radioman30/ATU_450_Tuner/docs/ATU450_Arhiva_Proiect.docx

ATU-450 TUNER CONTROLLER

Arhiva proiect — Arduino MEGA 2560

Yaesu FT-450 · BU2152FS · 24 relee · OLED · SWR Meter

# 1. Descriere proiect

Proiectul reprezinta un controller Arduino MEGA 2560 pentru tuner-ul automat de antena ATU-450, optiune pentru statia Yaesu FT-450. Controlerul inlocuieste logica originala cu un Arduino, adaugand display OLED, rotary encoder, masurare SWR in timp real, auto-tune cu hill-climbing si memorie EEPROM.

## 1.1 Hardware

Componenta | Detalii
Microcontroller | Arduino MEGA 2560
Display | OLED 1.3" SH1106 — I2C (SDA=pin20, SCL=pin21)
Driver relee | BU2152FS — 24 iesiri serial-in/parallel-out
Interfata SPI | Software: SDATA=pin11, SCLK=pin13, LE=pin10
Encoder | Rotary encoder cu buton — INT0(pin2), INT1(pin3)
Butoane | BTN_1=pin5 (mod), BTN_2=pin6 (actiune)
SWR Bridge | Punte directionala externa — FWD=A0, REV=A1
Relee | 24x NY-5W-K-IE DC5V (RL6001-RL6024)
Bobine | L6004-L6010 aer, L6011-L6013 toroidale T80

## 1.2 Versiuni cod

Versiune | Modificari
v3.0 (original) | Auto-tune +-4 pasi, fara EEPROM, 6 moduri
v4.0 (actualizat) | Hill-climbing complet, EEPROM 20 memorii, 7 moduri, fix ordine relee

# 2. IC BU2152FS — Mapare pini

BU2152FS (Rohm) este un convertor serial-in/parallel-out de 24 biti intr-un singur IC SSOP-32. Nu sunt 3 IC-uri separate — toate cele 24 relee sunt controlate de un singur chip prin interfata seriala de 4 fire.

## 2.1 Pini principali

Pin | Functie
Pin 2 | CLK — Serial Clock Input
Pin 4 | DATA — Serial Data Input
Pin 29 | SO — Serial Data Output (cascadare)
Pin 30 | STB — Strobe / Latch (activ Low)
Pin 31 | CLB — Clear (activ Low)
Pin 32 | VDD — Alimentare 5V
Pin 1, 3 | VSS — Masa
Pin 5-28 | P1...P24 — 24 iesiri paralele

## 2.2 Mapare P1-P24 catre relee (confirmata din schema)

Confirmat din schema electrica ATU-450 — pinii BU2152FS catre releele corespunzatoare:

Pin BU2152FS | Iesire Px | Releu / Functie
Pin 5 | P1 | RL6017 — Inductanta 1 (prima)
Pin 6 | P2 | RL6018 — Inductanta 2
Pin 7 | P3 | RL6019 — Inductanta 3
Pin 8 | P4 | RL6020 — Inductanta 4
Pin 9 | P5 | RL6021 — Inductanta 5
Pin 10 | P6 | RL6022 — Inductanta 6
Pin 11 | P7 | RL6023 — Inductanta 7
Pin 12 | P8 | RL6024 — Inductanta 8 (ultima)
Pin 13 | P9 | RL6009 — Condensator C2, primul
Pin 14 | P10 | RL6010 — Condensator C2
Pin 15 | P11 | RL6011 — Condensator C2
Pin 16 | P12 | RL6012 — Condensator C2
Pin 17 | P13 | RL6013 — Condensator C2
Pin 18 | P14 | RL6014 — Condensator C2
Pin 19 | P15 | RL6015 — Condensator C2
Pin 20 | P16 | RL6016 — Condensator C2, ultimul
Pin 21 | P17 | RL6001 — Condensator C1, primul
Pin 22 | P18 | RL6002 — Condensator C1
Pin 23 | P19 | RL6003 — Condensator C1
Pin 24 | P20 | RL6004 — Condensator C1
Pin 25 | P21 | RL6005 — Condensator C1
Pin 26 | P22 | RL6006 — Condensator C1
Pin 27 | P23 | RL6007 — Condensator C1
Pin 28 | P24 | RL6008 — Condensator C1, ultimul

# 3. Ordine shiftOut — Analiza si fix

## 3.1 Problema identificata

Cu shiftOut MSBFIRST, primul byte trimis este impins cel mai departe in registrul serial. Lantul intern BU2152FS:

shiftOut(byte1) -> primul trimis -> ajunge la P17-P24 = RL6001-6008 (C1)

shiftOut(byte2) -> al doilea -> ajunge la P9-P16 = RL6009-6016 (C2)

shiftOut(byte3) -> ultimul -> ajunge la P1-P8 = RL6017-6024 (L)

## 3.2 Codul v3.0 original — GRESIT

shiftOut(SDATA_PIN, SCLK_PIN, MSBFIRST, cap2); // GRESIT -> mergea la C1

shiftOut(SDATA_PIN, SCLK_PIN, MSBFIRST, cap1); // GRESIT -> mergea la C2

shiftOut(SDATA_PIN, SCLK_PIN, MSBFIRST, inductance); // Corect

## 3.3 Codul v4.0 — FIX APLICAT

// BU2152FS pinout confirmat din schema ATU-450:

// P1-P8 (pin5-12) = RL6017-6024 = INDUCTANTE <- ultimul shiftOut

// P9-P16 (pin13-20) = RL6009-6016 = CAP2 <- al doilea shiftOut

// P17-P24(pin21-28) = RL6001-6008 = CAP1 <- primul shiftOut

shiftOut(SDATA_PIN, SCLK_PIN, MSBFIRST, cap1); // -> P17-P24 = RL6001-6008

shiftOut(SDATA_PIN, SCLK_PIN, MSBFIRST, cap2); // -> P9-P16 = RL6009-6016

shiftOut(SDATA_PIN, SCLK_PIN, MSBFIRST, inductance); // -> P1-P8 = RL6017-6024

# 4. Auto-tune v2 — Hill Climbing

## 4.1 Algoritm v3.0 original

Cautare simpla +-4 pasi fata de preset, o singura trecere pe fiecare axa (L, C1, C2). Limitat — nu gaseste minimul real daca antena e departe de preset.

## 4.2 Algoritm v4.0 — Hill Climbing complet

Iteratie multipla pe toate 3 axele pana la convergenta sau timeout (8 secunde). Doua viteze de cautare:

Tip pas | Conditie
Pasi mici +-1 | Intotdeauna, pentru fine-tuning
Pasi mari +-8 din 2 in 2 | Doar cand SWR > 2.0 (departe de optim)
Stop timpuriu | SWR < 1.15 (AUTOTUNE_TARGET_SWR)
Timeout | 8000ms (AUTOTUNE_TIMEOUT)
Putere minima FWD | ADC > 40 (AUTOTUNE_MIN_FWD)

## 4.3 Secventa de cautare per iteratie

while (improved && !timeout) {

// Axa L: pasi +-1, apoi +-8 daca SWR>2

// Axa C1: pasi +-1, apoi +-8 daca SWR>2

// Axa C2: pasi +-1, apoi +-8 daca SWR>2

// Stop daca SWR <= 1.15

}

// Aplica cel mai bun rezultat gasit

// Salveaza automat in EEPROM

# 5. EEPROM — Memorii nevolatile

## 5.1 Layout EEPROM

Adresa | Continut | Descriere
0 | Magic byte (0xA5) | Detectie prima pornire
1 | Last L | Ultima inductanta activa
2 | Last C1 | Ultimul C1 activ
3 | Last C2 | Ultimul C2 activ
4 | Last preset | Ultimul preset de banda
10-109 | 20 x memorii | 5 bytes/memorie: valid+L+C1+C2+preset

## 5.2 Functionalitate

La fiecare modificare a setarilor (preset, manual, autotune, OFF), setarile sunt salvate automat in EEPROM via EEPROM.update() (nu write — protejeaza celulele, scrie doar daca valoarea s-a schimbat).

La pornire, ultima setare este restaurata automat si aplicata releelor.

20 sloturi de memorie utilizator, accesibile din MODE_MEMORY sau prin comenzi seriale SAVE/LOAD.

# 6. Moduri de operare

Mod | Functie
MODE_PRESET (0) | Selectie banda din lista (160m-6m) cu encoder. Encoder press = aplica preset.
MODE_MANUAL_L (1) | Reglaj manual inductanta (0-255). Encoder press = aplica.
MODE_MANUAL_C1 (2) | Reglaj manual condensator C1 (P17-24 = RL6001-6008).
MODE_MANUAL_C2 (3) | Reglaj manual condensator C2 (P9-16 = RL6009-6016).
MODE_SWR (4) | Afisaj live SWR + bare grafice. Encoder press = AUTOTUNE.
MODE_MEMORY (5) | Browse 20 sloturi. Encoder press = load. BTN2 = save/delete.
MODE_TEST (6) | Test secvential 24 relee cu progress bar.

Schimbare mod: BTN_1 cicleaza prin toate cele 7 moduri.

BTN_2 in moduri normale = ALL OFF (toate releele dezactivate + salveaza in EEPROM).

# 7. Comenzi seriale (115200 baud)

Comanda | Efect
TEST | Test secvential toate cele 24 relee
OFF | Toate releele OFF + salveaza EEPROM
MODE | Schimba modul (cicleaza 0-6)
TUNE | Aplica presetul benzii curente
SWR | Citeste si afiseaza SWR, FWD, REV
AUTOTUNE | Porneste hill-climbing auto-tune
INFO | Status complet + RAM liber
MEM | Listeaza toate memoriile salvate
SAVE <0-19> | Salveaza setarile curente in slotul specificat
LOAD <0-19> | Incarca memoria din slotul specificat
PRESET <0-10> | Seteaza banda direct (0=160m ... 10=6m)
LCC L C1 C2 | Control direct 0-255. Ex: LCC 15 240 128
RESET | Sterge toate memoriile EEPROM
? | Afiseaza lista completa de comenzi

# 8. Modul SWR Bridge — Constructie

## 8.1 Schema (Directional Coupler)

Punte directionala cu toroid FT37-43 si diode Schottky detectoare. Separa puterea directa (FWD) de puterea reflectata (REV).

## 8.2 Lista componente SWR Bridge

Referinta | Valoare | Descriere
T1 | FT37-43 | Toroid binocular material 43 (HF)
D1, D2 | 1N5711 | Diode Schottky detector (pereche, acelasi lot)
R1, R3 | 50 ohm 1% | Rezistenta sarcina — trebuie imperecheate +-1%
R2, R4 | 10k ohm | Bleed resistor (descarca condensatoarele)
R5, R6 | 1k ohm | Protectie intrari ADC Mega
C1, C2 | 100nF | Filtru semnal detectat (ceramic SMD)
C3 | 100pF | Bypass pe linia RF principala

## 8.3 Infasurare toroid T1

Infasurare | Detalii
Primar (PRI) | 1 tura — conductorul RF principal trece prin miez
Secundar (FWD) | 10 ture AWG26 — canal putere directa
Tertiar (REV) | 10 ture AWG26 — canal putere reflectata

## 8.4 Formule SWR

Gamma (coef. reflexie) = V_REV / V_FWD

SWR = (1 + Gamma) / (1 - Gamma)

Putere reflectata % = Gamma^2 * 100

In cod Arduino:

float gamma = (float)revRaw / (float)fwdRaw;

float swr = (1.0f + gamma) / (1.0f - gamma);

## 8.5 Conectare la MEGA 2560

Pin MEGA | Semnal
A0 | FWD — putere directa
A1 | REV — putere reflectata
GND | Masa comuna

# 9. Preseturi de banda

Banda | Frecventa | L / C1 / C2 (hex)
160m | 1.900 MHz | 0xFF / 0xF0 / 0x00
80m | 3.750 MHz | 0x7F / 0xF8 / 0x00
60m | 5.350 MHz | 0x3F / 0x7C / 0x08
40m | 7.150 MHz | 0x1F / 0x3E / 0x18
30m | 10.100 MHz | 0x0F / 0x1F / 0x38
20m | 14.200 MHz | 0x07 / 0x0F / 0x78
17m | 18.100 MHz | 0x03 / 0x07 / 0xF0
15m | 21.200 MHz | 0x01 / 0x03 / 0xF8
12m | 24.900 MHz | 0x00 / 0x01 / 0xFC
10m | 28.500 MHz | 0x00 / 0x00 / 0xFE
6m | 50.000 MHz | 0x00 / 0x00 / 0x7F

Preseturile sunt stocate in PROGMEM pentru economie de RAM (~110 bytes economisite).

# 10. Note specifice Arduino MEGA 2560

Aspect | Detalii MEGA 2560
I2C (OLED) | SDA=pin20, SCL=pin21 (NU A4/A5 ca la Uno)
INT externe | INT0=pin2, INT1=pin3 (folositi pentru encoder)
SPI hardware | 51(MOSI), 52(SCK), 53(SS) — neutilizat, cod foloseste shiftOut software
SPI software | SDATA=pin11, SCLK=pin13 — orice pini digitali
EEPROM | 4096 bytes disponibili (vs 1024 la Uno)
RAM | 8KB SRAM — freeMemory() raportat in comanda INFO
freeMemory() | Compatibil AVR direct (extern __heap_start, __brkval)
EEPROM.update() | Folosit in loc de write() — nu scrie daca valoarea e identica

# 11. Fisiere proiect

Fisier | Continut
ATU_450_Tuner_v3.ino | Cod original — referinta
ATU_450_Tuner_v4.ino | Cod actualizat MEGA 2560 — versiunea finala cu fix ordine relee
SWR_Bridge_Schema.html | Schema electronica modul SWR Bridge (interactiva, dark theme)
schema_ATU450.png | Schema electrica originala ATU-450 extrasa din PDF Yaesu
ATU450_Arhiva_Proiect.docx | Acest document — arhiva completa a proiectului

Yaesu FT-450 / ATU-450 — Arduino MEGA 2560 Controller

BU2152FS © Rohm Semiconductor | Proiect open-source

ATU-450 Tuner Controller — Arduino MEGA 2560 v4.0
