radioman30/ATU_450_Tuner/docs/SWR_Bridge_Schema.png

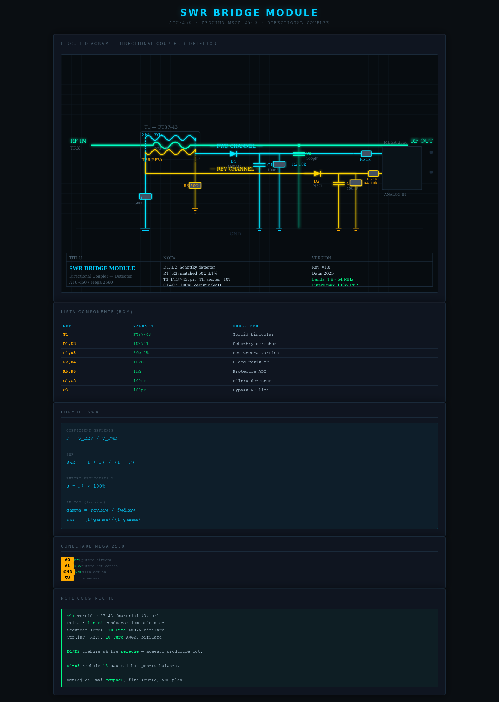
docs/SWR_Bridge_Schema.png
