radioman30/ATU_450_Tuner/(commit log)

2026-02-17 v4.0: Arduino MEGA 2560, EEPROM 20 memorii, auto-tune v2 hill-climbing
2026-02-17 v4 fix: ordinea releelor C1/C2 confirmata din schema ATU-450; documentatie
    [ATU_450_Tuner.ino]
